BareConductive/picap_cad_files/readme.md

Bare Conductive (http://www.bareconductive.com/)

# Bare Conductive Pi Cap CAD files

These are the CAD files for the [Pi Cap](http://www.bareconductive.com/shop/pi-cap/).
