BareConductive/picap_cad_files/eagle_files/Pi_Cap.brd

## EAGLE design eagle_files/Pi_Cap.brd (2016-12-01)

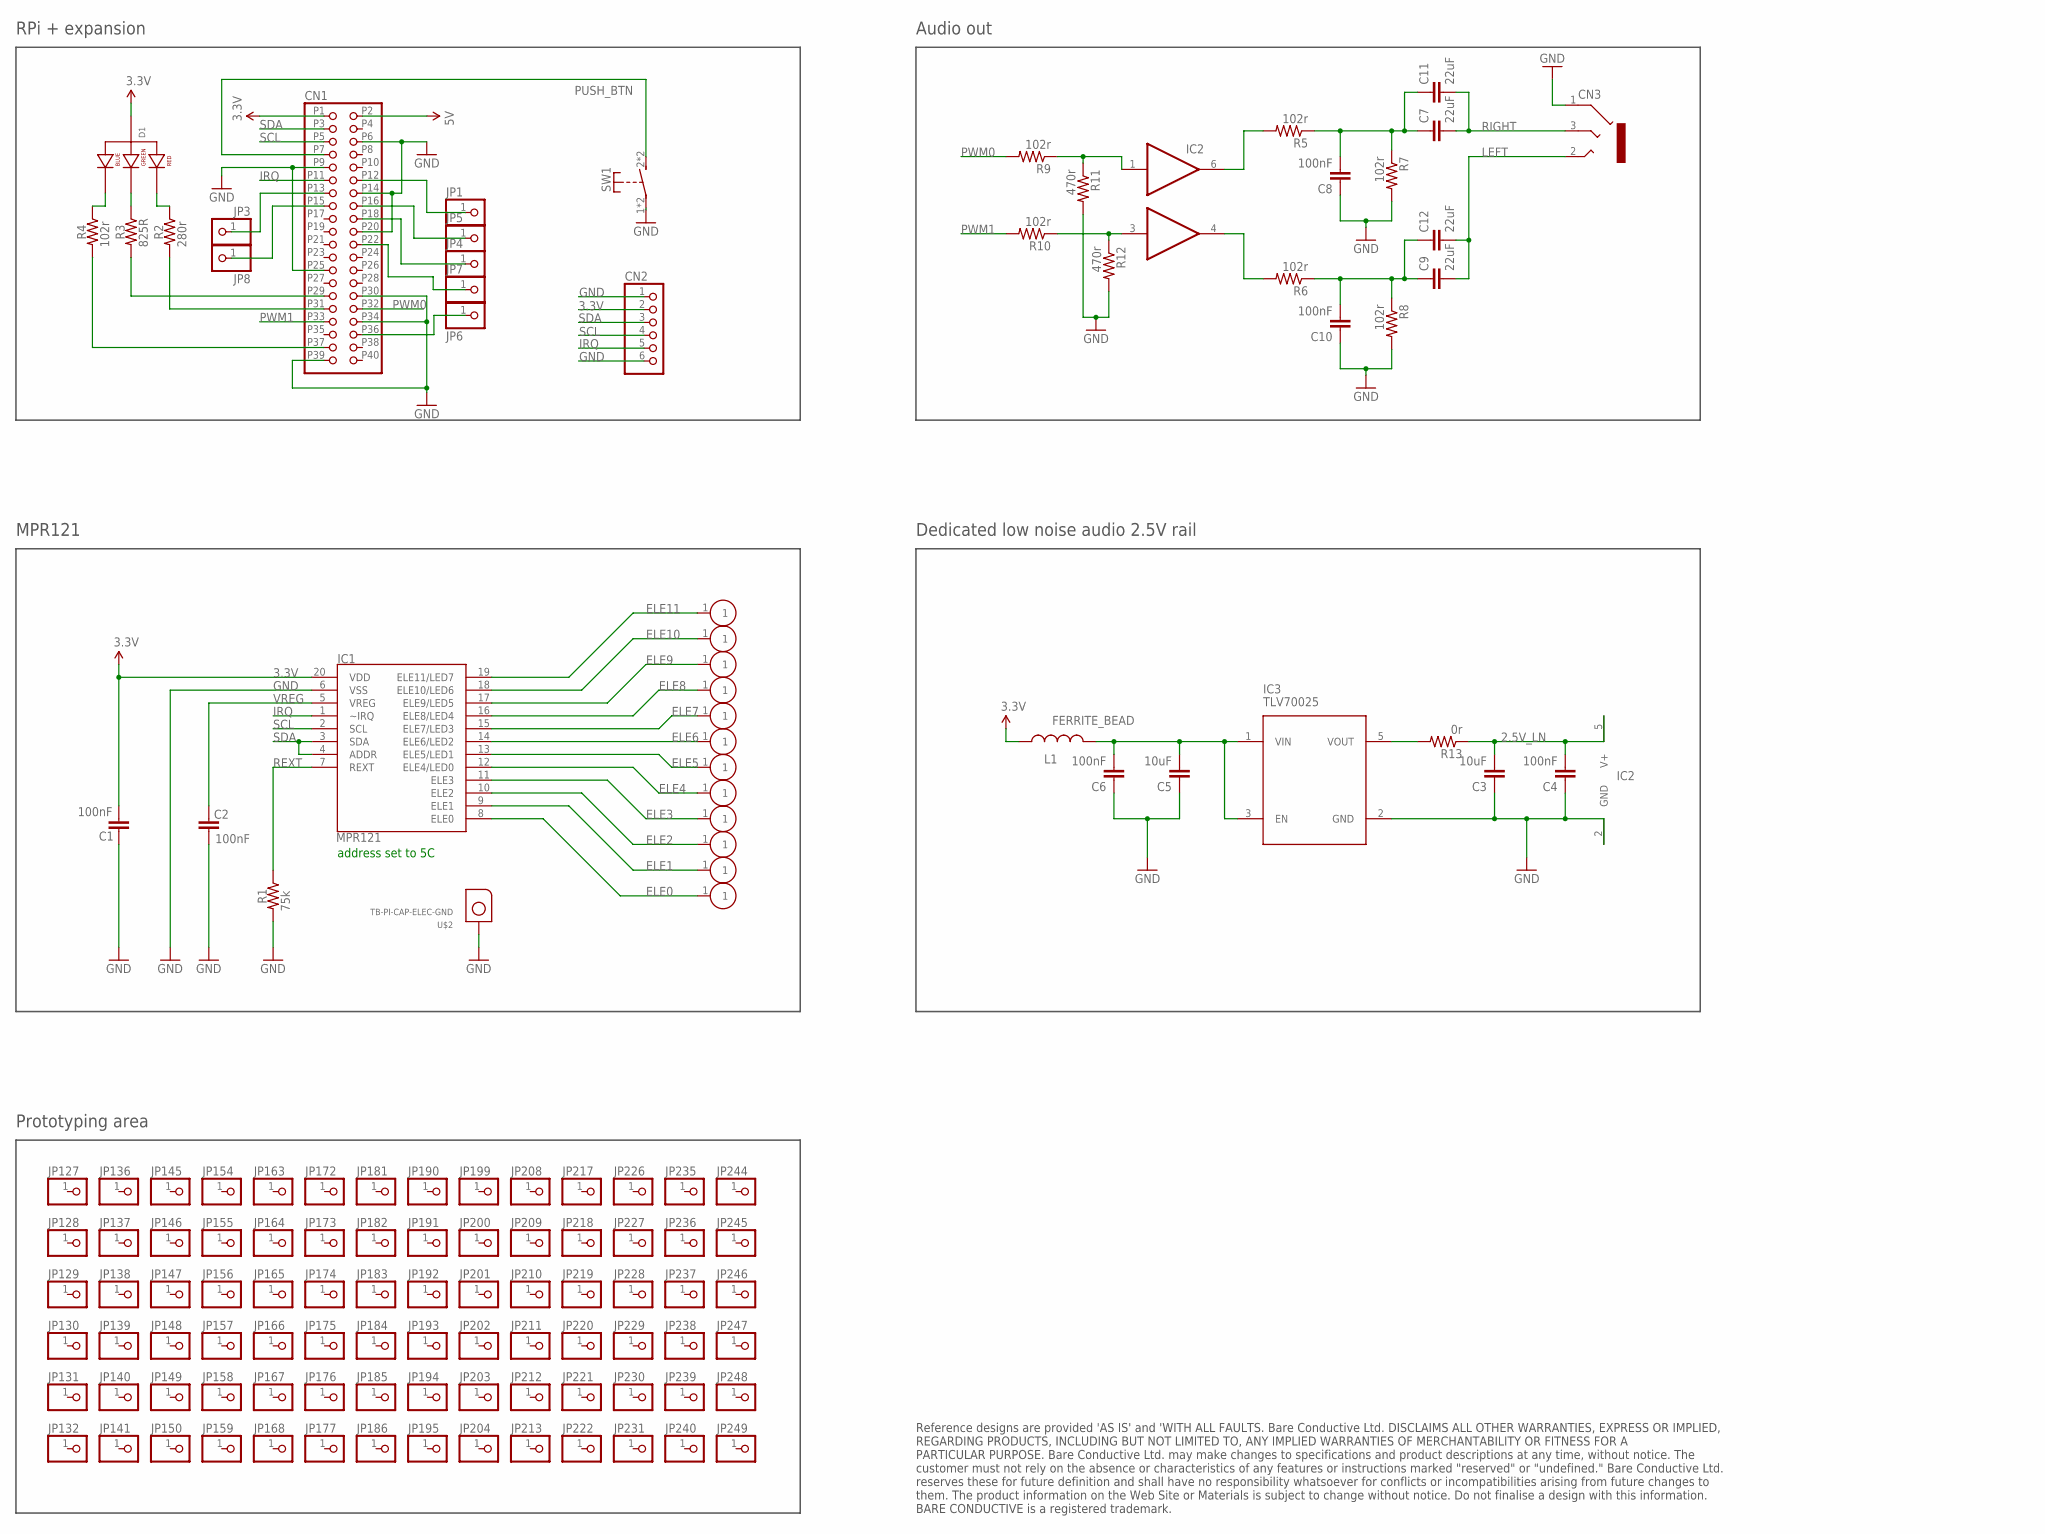
[picture p2: schematic Pi_Cap.sch]

Parts:
C1, C2, C4, C6, C8, C10: 100nF; 0402-CAP
C3, C5: 10uF; 1206
C7, C9, C11, C12: 22uF; 1206
CN1: PINHD-2X20/2X20_SMD; 2X20_SMD
CN2: 6W_0.5MM_FFC_RA_SMD
CN3: STEREO_SOCKET; SMD_STEREO_SOCKET
D1: PLCC4_RGB_LED; LED-3528
IC1: MPR121; QFN-20-0.4MM
IC2: DUAL_BUFFER; SOT-363
IC3: TLV70025; SC70
JP1, JP3, JP4, JP5, JP6, JP7, JP8, JP127, JP128, JP129, JP130, JP131, JP132, JP136, JP137, JP138, JP139, JP140, JP141, JP145, JP146, JP147, JP148, JP149, JP150, JP154, JP155, JP156, JP157, JP158, JP159, JP163, JP164, JP165, JP166, JP167, JP168, JP172, JP173, JP174, JP175, JP176, JP177, JP181, JP182, JP183, JP184, JP185, JP186, JP190, JP191, JP192, JP193, JP194, JP195, JP199, JP200, JP201, JP202, JP203, JP204, JP208, JP209, JP210, JP211, JP212, JP213, JP217, JP218, JP219, JP220, JP221, JP222, JP226, JP227, JP228, JP229, JP230, JP231, JP235, JP236, JP237, JP238, JP239, JP240, JP244, JP245, JP246, JP247, JP248, JP249: PINHD-1X1CB; 1X01-CLEANBIG
L1: FERRITE_BEAD; C0402
R1: 75k; 0402-RES
R2: 280r; 0402-RES
R3: 825R; 0402-RES
R4, R5, R6, R7, R8, R9, R10: 102r; 0402-RES
R11, R12: 470r; 0402-RES
R13: 0r; 0402-RES
SW1: SMD_RA_PUSH_SW
U$1: EDGE-ELEC-LEFT
U$2: TB-PI-CAP-ELEC-GND
U$3: EDGE-ELEC-RIGHT
U$17, U$18, U$22, U$24, U$26, U$27, U$28, U$29, U$30, U$31: EDGE-ELEC

Connections:
2.5V_LN: C3.2, C4.2, IC2.5 (V+), R13.1
3.3V: C1.1, CN1.P1 (1), CN2.2, D1.1 (ANODE), IC1.20 (VDD), L1.1
5V: CN1.P2 (2)
ELE0: IC1.8 (ELE0), U$1.1
ELE1: IC1.9 (ELE1), U$31.1
ELE2: IC1.10 (ELE2), U$30.1
ELE3: IC1.11 (ELE3), U$29.1
ELE4: IC1.12 (ELE4/LED0), U$28.1
ELE5: IC1.13 (ELE5/LED1), U$27.1
ELE6: IC1.14 (ELE6/LED2), U$26.1
ELE7: IC1.15 (ELE7/LED3), U$24.1
ELE8: IC1.16 (ELE8/LED4), U$22.1
ELE9: IC1.17 (ELE9/LED5), U$18.1
ELE10: IC1.18 (ELE10/LED6), U$17.1
ELE11: IC1.19 (ELE11/LED7), U$3.1
GND: C1.2, C2.1, C3.1, C4.1, C5.1, C6.1, C8.1, C10.1, CN1.P6 (6), CN1.P9 (9), CN1.P14 (14), CN1.P20 (20), CN1.P25 (25), CN1.P30 (30), CN1.P34 (34), CN1.P39 (39), CN2.1, CN2.6, CN3.1, IC1.6 (VSS), IC2.2 (GND), IC3.2 (GND), R1.2, R7.2, R8.2, R11.2, R12.2, SW1.1, SW1.3, U$2.1
IRQ: CN1.P11 (11), CN2.5, IC1.1 (~IRQ)
LEFT: C9.2, C12.2, CN3.2
unnamed: D1.2 (BLUE_CATHODE), R4.1
unnamed: D1.4 (GREEN_CATHODE), R3.1
unnamed: D1.3 (RED_CATHODE), R2.1
unnamed: CN1.P31 (31), R2.2
unnamed: CN1.P29 (29), R3.2
unnamed: CN1.P13 (13), JP3.1
unnamed: CN1.P37 (37), R4.2
unnamed: CN1.P36 (36), JP6.1
unnamed: CN1.P22 (22), JP7.1
unnamed: CN1.P18 (18), JP4.1
unnamed: CN1.P16 (16), JP5.1
unnamed: IC2.1 (IN_1), R9.1, R11.1
unnamed: CN1.P12 (12), JP1.1
unnamed: IC2.6 (OUT_1), R5.2
unnamed: IC2.4 (OUT_2), R6.2
unnamed: CN1.P15 (15), JP8.1
unnamed: C7.1, C8.2, C11.1, R5.1, R7.1
unnamed: IC2.3 (IN_2), R10.1, R12.1
unnamed: C9.1, C10.2, C12.1, R6.1, R8.1
unnamed: C5.2, C6.2, IC3.1 (VIN), IC3.3 (EN), L1.2
unnamed: IC3.5 (VOUT), R13.2
PUSH_BTN: CN1.P7 (7), SW1.2 (S), SW1.4 (S)
PWM0: CN1.P32 (32), R9.2
PWM1: CN1.P33 (33), R10.2
REXT: IC1.7 (REXT), R1.1
RIGHT: C7.2, C11.2, CN3.3
SCL: CN1.P5 (5), CN2.4, IC1.2 (SCL)
SDA: CN1.P3 (3), CN2.3, IC1.3 (SDA), IC1.4 (ADDR)
VREG: C2.2, IC1.5 (VREG)

Notes on the sheet:
Reference designs are provided 'AS IS' and 'WITH ALL FAULTS. Bare Conductive Ltd. DISCLAIMS ALL OTHER WARRANTIES, EXPRESS OR IMPLIED, REGARDING PRODUCTS, INCLUDING BUT NOT LIMITED TO, ANY IMPLIED WARRANTIES OF MERCHANTABILITY OR FITNESS FOR A PARTICULAR PURPOSE. Bare Conductive Ltd. may make change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
address set to 5C
Prototyping area
MPR121
RPi + expansion
Audio out
Dedicated low noise audio 2.5V rail
IC2

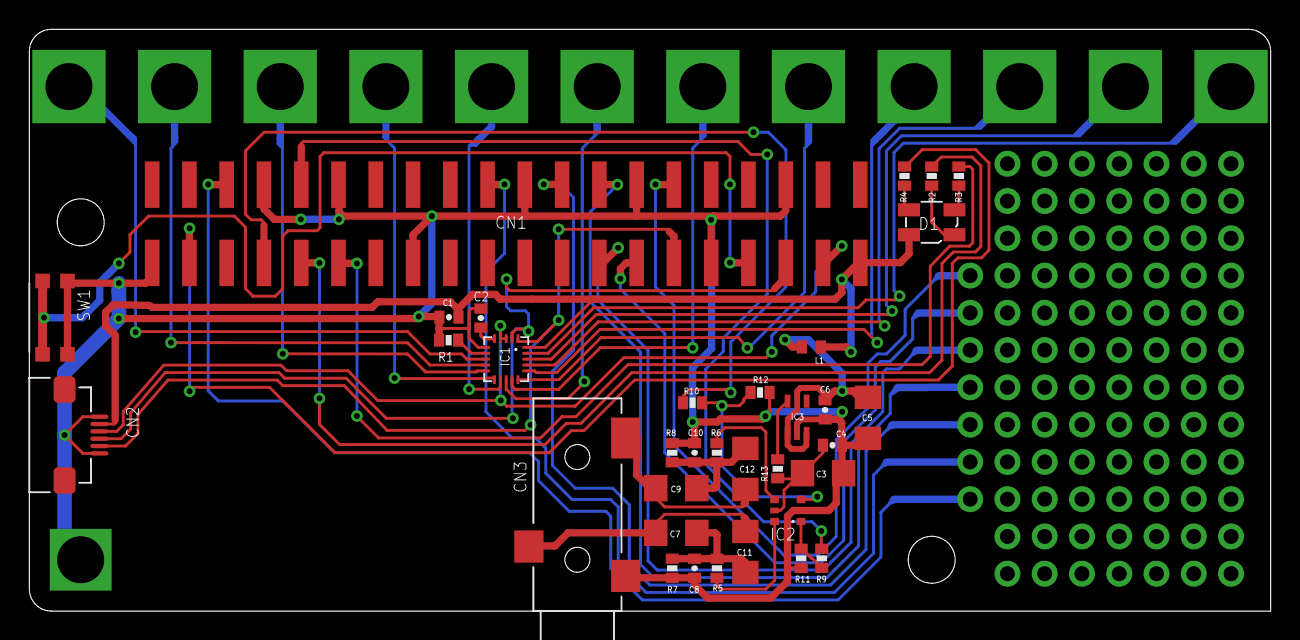
[picture p3: board Pi_Cap.brd from above]

Board: 4 copper layers, 84.6 x 39.6 mm, 138 parts (1 on the bottom side), 46 nets.
